ducpl2006/riscv_soc_de10_lite/tmp/pdfs/images/paper_obj_57.jpg

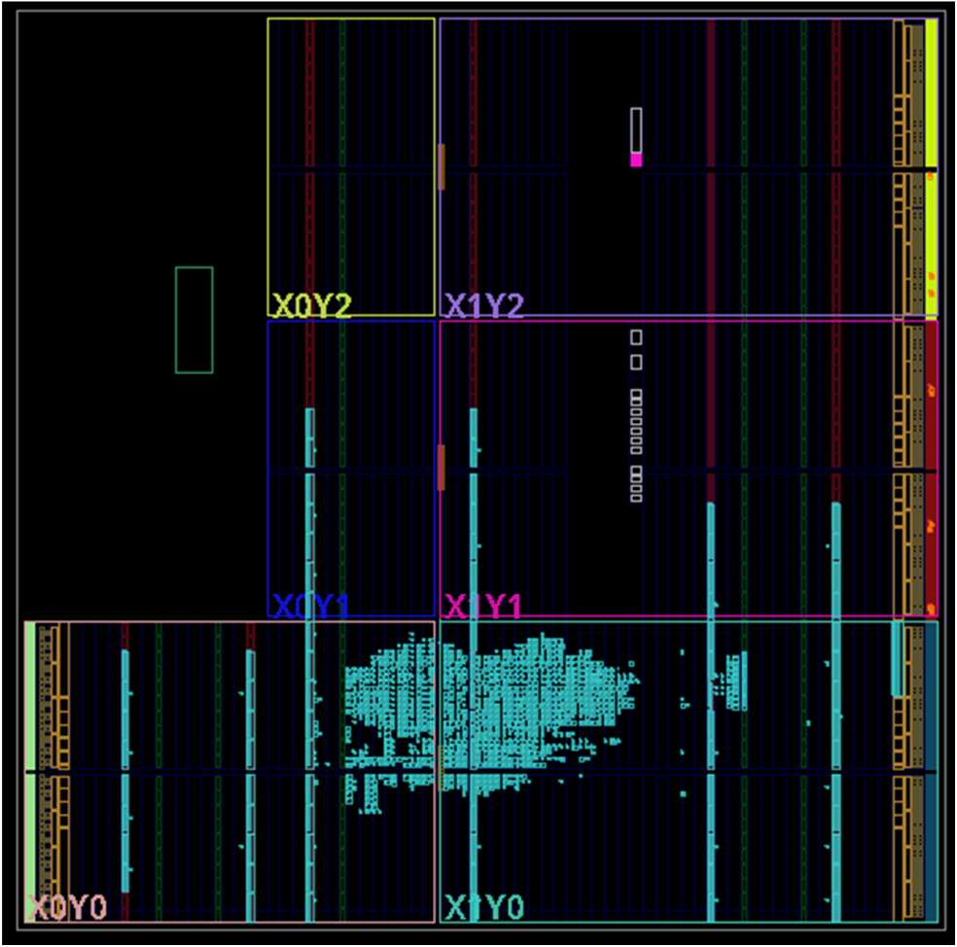
tmp/pdfs/images/paper_obj_57.jpg
