ducpl2006/riscv_soc_de10_lite/tmp/pdfs/images/paper_obj_48.jpg

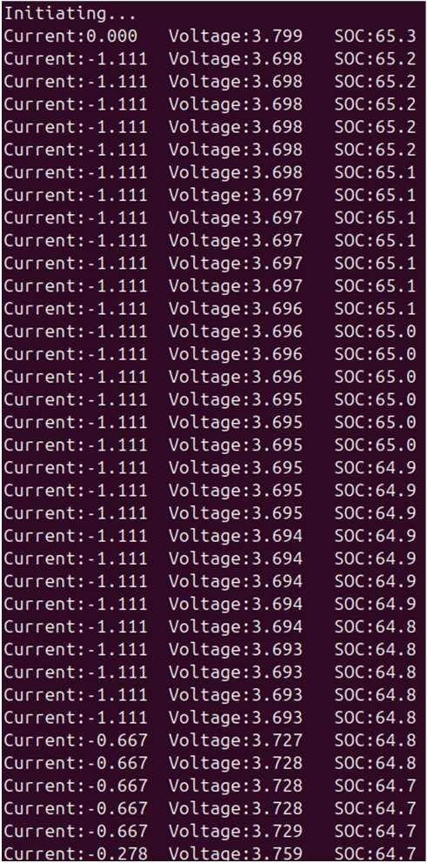
tmp/pdfs/images/paper_obj_48.jpg
