ducpl2006/riscv_soc_de10_lite/tmp/review_copy2_20260930/extract_list.txt

riscv_soc_de10_lite - Copy\.gitignore
riscv_soc_de10_lite - Copy\AGENTS.md
riscv_soc_de10_lite - Copy\docs\bao_cao_chat_luong_20260928_vi.md
riscv_soc_de10_lite - Copy\docs\bao_cao_freeze_isa_soc_vi.md
riscv_soc_de10_lite - Copy\docs\bao_cao_kien_truc_p0_p1_vi.md
riscv_soc_de10_lite - Copy\docs\bao_cao_xac_minh_vi.md
riscv_soc_de10_lite - Copy\docs\core_frozen_manifest.json
riscv_soc_de10_lite - Copy\docs\core_readability_baseline_20260929.zip
riscv_soc_de10_lite - Copy\docs\dac_ta_core_bus_ngoai_vi.md
riscv_soc_de10_lite - Copy\docs\doc_hieu_core_vi.md
riscv_soc_de10_lite - Copy\docs\firmware_ina228_vi.md
riscv_soc_de10_lite - Copy\docs\freeze_phase_files.json
riscv_soc_de10_lite - Copy\docs\giao_tiep_rtl_vi.md
riscv_soc_de10_lite - Copy\docs\hoc_hoi_soc_cnn_driver_vi.md
riscv_soc_de10_lite - Copy\docs\isa_scope_vi.md
riscv_soc_de10_lite - Copy\docs\isa_verification_vi.md
riscv_soc_de10_lite - Copy\docs\kiem_chung_board_vi.md
riscv_soc_de10_lite - Copy\docs\kien_truc_rv32i_vi.md
riscv_soc_de10_lite - Copy\docs\module_va_testbench_vi.md
riscv_soc_de10_lite - Copy\docs\soc_qnn_de10_lite_vi.md
riscv_soc_de10_lite - Copy\docs\timing_review_freeze_vi.md
riscv_soc_de10_lite - Copy\firmware\build\boot.hex
riscv_soc_de10_lite - Copy\firmware\build\boot.mif
riscv_soc_de10_lite - Copy\firmware\ina228.c
riscv_soc_de10_lite - Copy\firmware\include\board_config.h
riscv_soc_de10_lite - Copy\firmware\include\ina228.h
riscv_soc_de10_lite - Copy\firmware\include\model_config.h
riscv_soc_de10_lite - Copy\firmware\include\sample_pipeline.h
riscv_soc_de10_lite - Copy\firmware\include\soc_map.h
riscv_soc_de10_lite - Copy\firmware\include\soc_platform.h
riscv_soc_de10_lite - Copy\firmware\linker.ld
riscv_soc_de10_lite - Copy\firmware\main.c
riscv_soc_de10_lite - Copy\firmware\model\l1_biases.hex
riscv_soc_de10_lite - Copy\firmware\model\l1_weights.hex
riscv_soc_de10_lite - Copy\firmware\model\l1_weights.mif
riscv_soc_de10_lite - Copy\firmware\model\l2_biases.hex
riscv_soc_de10_lite - Copy\firmware\model\l2_weights.hex
riscv_soc_de10_lite - Copy\firmware\model\l2_weights.mif
riscv_soc_de10_lite - Copy\firmware\model\model_manifest.json
riscv_soc_de10_lite - Copy\firmware\model\out_bias.hex
riscv_soc_de10_lite - Copy\firmware\model\out_weights.hex
riscv_soc_de10_lite - Copy\firmware\model\verification_expected.hex
riscv_soc_de10_lite - Copy\firmware\model\verification_features.hex
riscv_soc_de10_lite - Copy\firmware\model\verification_meta.json
riscv_soc_de10_lite - Copy\firmware\runtime.c
riscv_soc_de10_lite - Copy\firmware\sample_pipeline.c
riscv_soc_de10_lite - Copy\firmware\soc_platform.c
riscv_soc_de10_lite - Copy\firmware\start.S
riscv_soc_de10_lite - Copy\ml\data\raw\SP2_0C_BJDST.zip
riscv_soc_de10_lite - Copy\ml\data\raw\SP2_0C_DST.zip
riscv_soc_de10_lite - Copy\ml\data\raw\SP2_0C_FUDS.zip
riscv_soc_de10_lite - Copy\ml\data\raw\SP2_0C_US06.zip
riscv_soc_de10_lite - Copy\ml\data\raw\SP2_25C_BJDST.zip
riscv_soc_de10_lite - Copy\ml\data\raw\SP2_25C_DST.zip
riscv_soc_de10_lite - Copy\ml\data\raw\SP2_25C_FUDS.zip
riscv_soc_de10_lite - Copy\ml\data\raw\SP2_25C_US06.zip
riscv_soc_de10_lite - Copy\ml\data\raw\SP2_45C_BJDST.zip
riscv_soc_de10_lite - Copy\ml\data\raw\SP2_45C_DST.zip
riscv_soc_de10_lite - Copy\ml\data\raw\SP2_45C_FUDS.zip
riscv_soc_de10_lite - Copy\ml\data\raw\SP2_45C_US06.zip
riscv_soc_de10_lite - Copy\ml\data\SHA256SUMS.txt
riscv_soc_de10_lite - Copy\ml\inspect_calce.py
riscv_soc_de10_lite - Copy\ml\requirements.txt
riscv_soc_de10_lite - Copy\ml\train_quantize_export.py
riscv_soc_de10_lite - Copy\quartus\riscv_soc.qpf
riscv_soc_de10_lite - Copy\quartus\riscv_soc.qsf
riscv_soc_de10_lite - Copy\quartus\riscv_soc.qws
riscv_soc_de10_lite - Copy\quartus\riscv_soc.sdc
riscv_soc_de10_lite - Copy\quartus\riscv_soc_nativelink_simulation.rpt
riscv_soc_de10_lite - Copy\README.md
riscv_soc_de10_lite - Copy\rtl\accelerator\qnn_model_config.vh
riscv_soc_de10_lite - Copy\rtl\accelerator\qnn_soc_accelerator.v
riscv_soc_de10_lite - Copy\rtl\board\de10_lite_top.v
riscv_soc_de10_lite - Copy\rtl\board\reset_controller.v
riscv_soc_de10_lite - Copy\rtl\bus\soc_bus.v
riscv_soc_de10_lite - Copy\rtl\bus\soc_map.vh
riscv_soc_de10_lite - Copy\rtl\core\common\rv32_lsu.v
riscv_soc_de10_lite - Copy\rtl\core\control\rv32_hazard_unit.v
riscv_soc_de10_lite - Copy\rtl\core\control\rv32_pipeline_control.v
riscv_soc_de10_lite - Copy\rtl\core\ex\rv32_alu.v
riscv_soc_de10_lite - Copy\rtl\core\ex\rv32_branch_unit.v
riscv_soc_de10_lite - Copy\rtl\core\ex\rv32_ex_stage.v
riscv_soc_de10_lite - Copy\rtl\core\id\rv32_decoder.v
riscv_soc_de10_lite - Copy\rtl\core\id\rv32_id_stage.v
riscv_soc_de10_lite - Copy\rtl\core\id\rv32_imm_gen.v
riscv_soc_de10_lite - Copy\rtl\core\id\rv32_regfile.v
riscv_soc_de10_lite - Copy\rtl\core\if\rv32_if_stage.v
riscv_soc_de10_lite - Copy\rtl\core\mem\rv32_mem_stage.v
riscv_soc_de10_lite - Copy\rtl\core\refactor_core.py
riscv_soc_de10_lite - Copy\rtl\core\rename_ports.py
riscv_soc_de10_lite - Copy\rtl\core\rename_ports_if.py
riscv_soc_de10_lite - Copy\rtl\core\rv32_core.v
riscv_soc_de10_lite - Copy\rtl\core\rv32_defs.vh
riscv_soc_de10_lite - Copy\rtl\core\rv32_pipeline_regs.v
riscv_soc_de10_lite - Copy\rtl\core\wb\rv32_wb_stage.v
riscv_soc_de10_lite - Copy\rtl\memory\intel_sync_ram_1p.v
riscv_soc_de10_lite - Copy\rtl\memory\intel_sync_rom_1p.v
riscv_soc_de10_lite - Copy\rtl\memory\intel_sync_rom_2p.v
riscv_soc_de10_lite - Copy\rtl\memory\soc_ram.v
riscv_soc_de10_lite - Copy\rtl\memory\soc_rom_dp.v
riscv_soc_de10_lite - Copy\rtl\peripherals\soc_gpio.v
riscv_soc_de10_lite - Copy\rtl\peripherals\soc_i2c_master.v
riscv_soc_de10_lite - Copy\rtl\peripherals\soc_timer.v
riscv_soc_de10_lite - Copy\rtl\peripherals\soc_uart_tx.v
riscv_soc_de10_lite - Copy\rtl\peripherals\uart\.gitignore
riscv_soc_de10_lite - Copy\rtl\peripherals\uart\docs\CHANGE_REPORT.md
riscv_soc_de10_lite - Copy\rtl\peripherals\uart\docs\LEARNING_GUIDE.md
riscv_soc_de10_lite - Copy\rtl\peripherals\uart\docs\SPECIFICATION.md
riscv_soc_de10_lite - Copy\rtl\peripherals\uart\quartus\pins.qsf
riscv_soc_de10_lite - Copy\rtl\peripherals\uart\quartus\README.md
riscv_soc_de10_lite - Copy\rtl\peripherals\uart\quartus\uart_loopback.qpf
riscv_soc_de10_lite - Copy\rtl\peripherals\uart\quartus\uart_loopback.qsf
riscv_soc_de10_lite - Copy\rtl\peripherals\uart\quartus\uart_loopback.sdc
riscv_soc_de10_lite - Copy\rtl\peripherals\uart\README.md
riscv_soc_de10_lite - Copy\rtl\peripherals\uart\rtl\reset_sync.v
riscv_soc_de10_lite - Copy\rtl\peripherals\uart\rtl\sync_fifo.v
riscv_soc_de10_lite - Copy\rtl\peripherals\uart\rtl\uart_baud_gen.v
riscv_soc_de10_lite - Copy\rtl\peripherals\uart\rtl\uart_loopback_top.v
riscv_soc_de10_lite - Copy\rtl\peripherals\uart\rtl\uart_rx.v
riscv_soc_de10_lite - Copy\rtl\peripherals\uart\rtl\uart_rx_sync.v
riscv_soc_de10_lite - Copy\rtl\peripherals\uart\rtl\uart_top.v
riscv_soc_de10_lite - Copy\rtl\peripherals\uart\rtl\uart_tx.v
riscv_soc_de10_lite - Copy\rtl\peripherals\uart\scripts\run_quartus_analysis.ps1
riscv_soc_de10_lite - Copy\rtl\peripherals\uart\scripts\run_tests.ps1
riscv_soc_de10_lite - Copy\rtl\peripherals\uart\soc_uart.v
riscv_soc_de10_lite - Copy\rtl\peripherals\uart\tb\tb_sync_fifo.v
riscv_soc_de10_lite - Copy\rtl\peripherals\uart\tb\tb_uart_baud_gen.v
riscv_soc_de10_lite - Copy\rtl\peripherals\uart\tb\tb_uart_loopback.v
riscv_soc_de10_lite - Copy\rtl\peripherals\uart\tb\tb_uart_rx.v
riscv_soc_de10_lite - Copy\rtl\peripherals\uart\tb\tb_uart_top.v
riscv_soc_de10_lite - Copy\rtl\peripherals\uart\tb\tb_uart_tx.v
riscv_soc_de10_lite - Copy\rtl\peripherals\uart\uart_rx.v
riscv_soc_de10_lite - Copy\rtl\peripherals\uart\uart_rx_fifo.v
riscv_soc_de10_lite - Copy\rtl\soc\rv32_soc.v
riscv_soc_de10_lite - Copy\scripts\build_firmware.ps1
riscv_soc_de10_lite - Copy\scripts\build_firmware.py
riscv_soc_de10_lite - Copy\scripts\check_core_freeze.py
riscv_soc_de10_lite - Copy\scripts\check_core_readability.py
riscv_soc_de10_lite - Copy\scripts\generate_firmware_vectors.py
riscv_soc_de10_lite - Copy\scripts\report_bus_timing.tcl
riscv_soc_de10_lite - Copy\scripts\report_freeze_phase.py
riscv_soc_de10_lite - Copy\scripts\report_timing.tcl
riscv_soc_de10_lite - Copy\scripts\run_firmware_tests.py
riscv_soc_de10_lite - Copy\scripts\run_isa.py
riscv_soc_de10_lite - Copy\scripts\run_tests.ps1
riscv_soc_de10_lite - Copy\scripts\run_tests.py
riscv_soc_de10_lite - Copy\scripts\setup_ml.ps1
riscv_soc_de10_lite - Copy\scripts\soc_rtl_sources.py
riscv_soc_de10_lite - Copy\scripts\train_model.ps1
riscv_soc_de10_lite - Copy\tb\accelerator\tb_rv32_qnn_model.v
riscv_soc_de10_lite - Copy\tb\accelerator\tb_rv32_qnn_soc_accelerator.v
riscv_soc_de10_lite - Copy\tb\bus\tb_rv32_soc_bus.v
riscv_soc_de10_lite - Copy\tb\core\common\tb_rv32_lsu.v
riscv_soc_de10_lite - Copy\tb\core\control\tb_rv32_hazard_unit.v
riscv_soc_de10_lite - Copy\tb\core\ex\tb_rv32_alu.v
riscv_soc_de10_lite - Copy\tb\core\ex\tb_rv32_branch_unit.v
riscv_soc_de10_lite - Copy\tb\core\id\tb_rv32_decoder.v
riscv_soc_de10_lite - Copy\tb\core\id\tb_rv32_imm_gen.v
riscv_soc_de10_lite - Copy\tb\core\id\tb_rv32_regfile.v
riscv_soc_de10_lite - Copy\tb\core\if\tb_rv32_if_stage.v
riscv_soc_de10_lite - Copy\tb\core\isa\env\link.ld
riscv_soc_de10_lite - Copy\tb\core\isa\env\riscv_test.h
riscv_soc_de10_lite - Copy\tb\core\isa\isa_core_harness.sv
riscv_soc_de10_lite - Copy\tb\core\tb_rv32_core.v
riscv_soc_de10_lite - Copy\tb\core\tb_rv32_core_fetch.v
riscv_soc_de10_lite - Copy\tb\core\tb_rv32_core_ordering.v
riscv_soc_de10_lite - Copy\tb\core\tb_rv32_core_traps.v
riscv_soc_de10_lite - Copy\tb\firmware\test_pipeline_ina228.c
riscv_soc_de10_lite - Copy\tb\memory\tb_rv32_soc_ram.v
riscv_soc_de10_lite - Copy\tb\memory\tb_rv32_soc_rom.v
riscv_soc_de10_lite - Copy\tb\peripherals\tb_rv32_gpio.v
riscv_soc_de10_lite - Copy\tb\peripherals\tb_rv32_i2c_master.v
riscv_soc_de10_lite - Copy\tb\peripherals\tb_rv32_i2c_recovery.v
riscv_soc_de10_lite - Copy\tb\peripherals\tb_rv32_i2c_transactions.v
riscv_soc_de10_lite - Copy\tb\peripherals\tb_rv32_timer.v
riscv_soc_de10_lite - Copy\tb\peripherals\tb_rv32_uart_fifo.v
riscv_soc_de10_lite - Copy\tb\peripherals\tb_rv32_uart_rx.v
riscv_soc_de10_lite - Copy\tb\peripherals\tb_rv32_uart_rx_fifo.v
riscv_soc_de10_lite - Copy\tb\peripherals\tb_rv32_uart_tx.v
riscv_soc_de10_lite - Copy\tb\soc\firmware_assets\build_manifest.json
riscv_soc_de10_lite - Copy\tb\soc\firmware_assets\bus_raw.hex
riscv_soc_de10_lite - Copy\tb\soc\firmware_assets\current_raw.hex
riscv_soc_de10_lite - Copy\tb\soc\firmware_assets\fake.hex
riscv_soc_de10_lite - Copy\tb\soc\firmware_assets\fake_features.hex
riscv_soc_de10_lite - Copy\tb\soc\firmware_assets\fake_reference.json
riscv_soc_de10_lite - Copy\tb\soc\firmware_assets\fake_results.hex
riscv_soc_de10_lite - Copy\tb\soc\firmware_assets\fake_uart.hex
riscv_soc_de10_lite - Copy\tb\soc\firmware_assets\fake_uart_length.hex
riscv_soc_de10_lite - Copy\tb\soc\firmware_assets\ina228.hex
riscv_soc_de10_lite - Copy\tb\soc\firmware_assets\ina228_features.hex
riscv_soc_de10_lite - Copy\tb\soc\firmware_assets\ina228_reference.json
riscv_soc_de10_lite - Copy\tb\soc\firmware_assets\ina228_results.hex
riscv_soc_de10_lite - Copy\tb\soc\firmware_assets\ina228_uart.hex
riscv_soc_de10_lite - Copy\tb\soc\firmware_assets\ina228_uart_length.hex
riscv_soc_de10_lite - Copy\tb\soc\firmware_assets\shunt_raw.hex
riscv_soc_de10_lite - Copy\tb\soc\tb_rv32_core_bus_wait.v
riscv_soc_de10_lite - Copy\tb\soc\tb_rv32_firmware_e2e.sv
riscv_soc_de10_lite - Copy\tb\soc\tb_rv32_reset_controller.v
riscv_soc_de10_lite - Copy\tb\soc\tb_rv32_soc.v
riscv_soc_de10_lite - Copy\tb\soc\tb_rv32_soc_mmio.v
riscv_soc_de10_lite - Copy\tb\soc\tb_rv32_soc_uart_rx.v
riscv_soc_de10_lite - Copy\third_party\README.md
riscv_soc_de10_lite - Copy\third_party\riscv-tests\.github\workflows\debug.yml
riscv_soc_de10_lite - Copy\third_party\riscv-tests\.github\workflows\spike-openocd-tests.yml
riscv_soc_de10_lite - Copy\third_party\riscv-tests\.github\workflows\spike-tests.yml
riscv_soc_de10_lite - Copy\third_party\riscv-tests\.gitignore
riscv_soc_de10_lite - Copy\third_party\riscv-tests\.gitmodules
riscv_soc_de10_lite - Copy\third_party\riscv-tests\benchmarks\common\crt.S
riscv_soc_de10_lite - Copy\third_party\riscv-tests\benchmarks\common\syscalls.c
riscv_soc_de10_lite - Copy\third_party\riscv-tests\benchmarks\common\test.ld
riscv_soc_de10_lite - Copy\third_party\riscv-tests\benchmarks\common\util.h
riscv_soc_de10_lite - Copy\third_party\riscv-tests\benchmarks\dhrystone\dhrystone.c
riscv_soc_de10_lite - Copy\third_party\riscv-tests\benchmarks\dhrystone\dhrystone.h
riscv_soc_de10_lite - Copy\third_party\riscv-tests\benchmarks\dhrystone\dhrystone_main.c
riscv_soc_de10_lite - Copy\third_party\riscv-tests\benchmarks\Makefile
riscv_soc_de10_lite - Copy\third_party\riscv-tests\benchmarks\median\dataset1.h
riscv_soc_de10_lite - Copy\third_party\riscv-tests\benchmarks\median\median.c
riscv_soc_de10_lite - Copy\third_party\riscv-tests\benchmarks\median\median.h
riscv_soc_de10_lite - Copy\third_party\riscv-tests\benchmarks\median\median_gendata.pl
riscv_soc_de10_lite - Copy\third_party\riscv-tests\benchmarks\median\median_main.c
riscv_soc_de10_lite - Copy\third_party\riscv-tests\benchmarks\memcpy\dataset1.h
riscv_soc_de10_lite - Copy\third_party\riscv-tests\benchmarks\memcpy\memcpy_gendata.pl
riscv_soc_de10_lite - Copy\third_party\riscv-tests\benchmarks\memcpy\memcpy_main.c
riscv_soc_de10_lite - Copy\third_party\riscv-tests\benchmarks\mm\common.h
riscv_soc_de10_lite - Copy\third_party\riscv-tests\benchmarks\mm\gen.scala
riscv_soc_de10_lite - Copy\third_party\riscv-tests\benchmarks\mm\mm.c
riscv_soc_de10_lite - Copy\third_party\riscv-tests\benchmarks\mm\mm_main.c
riscv_soc_de10_lite - Copy\third_party\riscv-tests\benchmarks\mm\rb.h
riscv_soc_de10_lite - Copy\third_party\riscv-tests\benchmarks\mt-matmul\dataset.h
riscv_soc_de10_lite - Copy\third_party\riscv-tests\benchmarks\mt-matmul\matmul.c
riscv_soc_de10_lite - Copy\third_party\riscv-tests\benchmarks\mt-matmul\matmul_gendata.pl
riscv_soc_de10_lite - Copy\third_party\riscv-tests\benchmarks\mt-matmul\mt-matmul.c
riscv_soc_de10_lite - Copy\third_party\riscv-tests\benchmarks\mt-memcpy\dataset1.h
riscv_soc_de10_lite - Copy\third_party\riscv-tests\benchmarks\mt-memcpy\memcpy_gendata.pl
riscv_soc_de10_lite - Copy\third_party\riscv-tests\benchmarks\mt-memcpy\mt-memcpy.c
riscv_soc_de10_lite - Copy\third_party\riscv-tests\benchmarks\mt-vvadd\dataset.h
riscv_soc_de10_lite - Copy\third_party\riscv-tests\benchmarks\mt-vvadd\mt-vvadd.c
riscv_soc_de10_lite - Copy\third_party\riscv-tests\benchmarks\mt-vvadd\vvadd.c
riscv_soc_de10_lite - Copy\third_party\riscv-tests\benchmarks\mt-vvadd\vvadd_gendata.pl
riscv_soc_de10_lite - Copy\third_party\riscv-tests\benchmarks\multiply\dataset1.h
riscv_soc_de10_lite - Copy\third_party\riscv-tests\benchmarks\multiply\multiply.c
riscv_soc_de10_lite - Copy\third_party\riscv-tests\benchmarks\multiply\multiply.h
riscv_soc_de10_lite - Copy\third_party\riscv-tests\benchmarks\multiply\multiply_gendata.pl
riscv_soc_de10_lite - Copy\third_party\riscv-tests\benchmarks\multiply\multiply_main.c
riscv_soc_de10_lite - Copy\third_party\riscv-tests\benchmarks\pmp\pmp.c
riscv_soc_de10_lite - Copy\third_party\riscv-tests\benchmarks\qsort\dataset1.h
riscv_soc_de10_lite - Copy\third_party\riscv-tests\benchmarks\qsort\qsort_gendata.pl
riscv_soc_de10_lite - Copy\third_party\riscv-tests\benchmarks\qsort\qsort_main.c
riscv_soc_de10_lite - Copy\third_party\riscv-tests\benchmarks\readme.txt
riscv_soc_de10_lite - Copy\third_party\riscv-tests\benchmarks\rsort\dataset1.h
riscv_soc_de10_lite - Copy\third_party\riscv-tests\benchmarks\rsort\rsort.c
riscv_soc_de10_lite - Copy\third_party\riscv-tests\benchmarks\spmv\dataset1.h
riscv_soc_de10_lite - Copy\third_party\riscv-tests\benchmarks\spmv\spmv_gendata.scala
riscv_soc_de10_lite - Copy\third_party\riscv-tests\benchmarks\spmv\spmv_main.c
riscv_soc_de10_lite - Copy\third_party\riscv-tests\benchmarks\towers\towers_main.c
riscv_soc_de10_lite - Copy\third_party\riscv-tests\benchmarks\vec-daxpy\dataset1.h
riscv_soc_de10_lite - Copy\third_party\riscv-tests\benchmarks\vec-daxpy\daxpy_gendata.pl
riscv_soc_de10_lite - Copy\third_party\riscv-tests\benchmarks\vec-daxpy\vec-daxpy.S
riscv_soc_de10_lite - Copy\third_party\riscv-tests\benchmarks\vec-daxpy\vec-daxpy_main.c
riscv_soc_de10_lite - Copy\third_party\riscv-tests\benchmarks\vec-memcpy\dataset1.h
riscv_soc_de10_lite - Copy\third_party\riscv-tests\benchmarks\vec-memcpy\memcpy_gendata.pl
riscv_soc_de10_lite - Copy\third_party\riscv-tests\benchmarks\vec-memcpy\vec-memcpy.S
riscv_soc_de10_lite - Copy\third_party\riscv-tests\benchmarks\vec-memcpy\vec-memcpy_main.c
riscv_soc_de10_lite - Copy\third_party\riscv-tests\benchmarks\vec-sgemm\dataset1.h
riscv_soc_de10_lite - Copy\third_party\riscv-tests\benchmarks\vec-sgemm\sgemm_gendata.pl
riscv_soc_de10_lite - Copy\third_party\riscv-tests\benchmarks\vec-sgemm\vec-sgemm.S
riscv_soc_de10_lite - Copy\third_party\riscv-tests\benchmarks\vec-sgemm\vec-sgemm_main.c
riscv_soc_de10_lite - Copy\third_party\riscv-tests\benchmarks\vec-strcmp\vec-strcmp.S
riscv_soc_de10_lite - Copy\third_party\riscv-tests\benchmarks\vec-strcmp\vec-strcmp_main.c
riscv_soc_de10_lite - Copy\third_party\riscv-tests\benchmarks\vvadd\dataset1-large.h
riscv_soc_de10_lite - Copy\third_party\riscv-tests\benchmarks\vvadd\dataset1.h
riscv_soc_de10_lite - Copy\third_party\riscv-tests\benchmarks\vvadd\vvadd_gendata.pl
riscv_soc_de10_lite - Copy\third_party\riscv-tests\benchmarks\vvadd\vvadd_main.c
riscv_soc_de10_lite - Copy\third_party\riscv-tests\configure
riscv_soc_de10_lite - Copy\third_party\riscv-tests\configure.ac
riscv_soc_de10_lite - Copy\third_party\riscv-tests\debug\bin\README.md
riscv_soc_de10_lite - Copy\third_party\riscv-tests\debug\bin\RTOSDemo32.axf
riscv_soc_de10_lite - Copy\third_party\riscv-tests\debug\bin\RTOSDemo64.axf
riscv_soc_de10_lite - Copy\third_party\riscv-tests\debug\excluded.yaml.example
riscv_soc_de10_lite - Copy\third_party\riscv-tests\debug\gdbserver.py
riscv_soc_de10_lite - Copy\third_party\riscv-tests\debug\hifive1_excludes.yaml
riscv_soc_de10_lite - Copy\third_party\riscv-tests\debug\Makefile
riscv_soc_de10_lite - Copy\third_party\riscv-tests\debug\openocd.py
riscv_soc_de10_lite - Copy\third_party\riscv-tests\debug\programs\checksum.c
riscv_soc_de10_lite - Copy\third_party\riscv-tests\debug\programs\counting_loop.c
riscv_soc_de10_lite - Copy\third_party\riscv-tests\debug\programs\debug.c
riscv_soc_de10_lite - Copy\third_party\riscv-tests\debug\programs\ebreak.c
riscv_soc_de10_lite - Copy\third_party\riscv-tests\debug\programs\entry.S
riscv_soc_de10_lite - Copy\third_party\riscv-tests\debug\programs\infinite_loop.S
riscv_soc_de10_lite - Copy\third_party\riscv-tests\debug\programs\init.c
riscv_soc_de10_lite - Copy\third_party\riscv-tests\debug\programs\init.h
riscv_soc_de10_lite - Copy\third_party\riscv-tests\debug\programs\interrupt.c
riscv_soc_de10_lite - Copy\third_party\riscv-tests\debug\programs\mprv.S
riscv_soc_de10_lite - Copy\third_party\riscv-tests\debug\programs\multicore.c
riscv_soc_de10_lite - Copy\third_party\riscv-tests\debug\programs\priv.S
riscv_soc_de10_lite - Copy\third_party\riscv-tests\debug\programs\regs.S
riscv_soc_de10_lite - Copy\third_party\riscv-tests\debug\programs\run_halt_timing.S
riscv_soc_de10_lite - Copy\third_party\riscv-tests\debug\programs\semihosting.c
riscv_soc_de10_lite - Copy\third_party\riscv-tests\debug\programs\semihosting.h
riscv_soc_de10_lite - Copy\third_party\riscv-tests\debug\programs\step.S
riscv_soc_de10_lite - Copy\third_party\riscv-tests\debug\programs\tiny-malloc.c
riscv_soc_de10_lite - Copy\third_party\riscv-tests\debug\programs\translate.c
riscv_soc_de10_lite - Copy\third_party\riscv-tests\debug\programs\trigger.S
riscv_soc_de10_lite - Copy\third_party\riscv-tests\debug\programs\vectors.S
riscv_soc_de10_lite - Copy\third_party\riscv-tests\debug\pylint.rc
riscv_soc_de10_lite - Copy\third_party\riscv-tests\debug\rbb_daisychain.py
riscv_soc_de10_lite - Copy\third_party\riscv-tests\debug\README.md
riscv_soc_de10_lite - Copy\third_party\riscv-tests\debug\requirements.txt
riscv_soc_de10_lite - Copy\third_party\riscv-tests\debug\targets\RISC-V\spike-1.cfg
riscv_soc_de10_lite - Copy\third_party\riscv-tests\debug\targets\RISC-V\spike-2-hwthread.cfg
riscv_soc_de10_lite - Copy\third_party\riscv-tests\debug\targets\RISC-V\spike-2.cfg
riscv_soc_de10_lite - Copy\third_party\riscv-tests\debug\targets\RISC-V\spike-multi.cfg
riscv_soc_de10_lite - Copy\third_party\riscv-tests\debug\targets\RISC-V\spike-multi.py
riscv_soc_de10_lite - Copy\third_party\riscv-tests\debug\targets\RISC-V\spike32-2-hwthread.py
riscv_soc_de10_lite - Copy\third_party\riscv-tests\debug\targets\RISC-V\spike32-2.py
riscv_soc_de10_lite - Copy\third_party\riscv-tests\debug\targets\RISC-V\spike32.lds
riscv_soc_de10_lite - Copy\third_party\riscv-tests\debug\targets\RISC-V\spike32.py
riscv_soc_de10_lite - Copy\third_party\riscv-tests\debug\targets\RISC-V\spike64-2-hwthread.py
riscv_soc_de10_lite - Copy\third_party\riscv-tests\debug\targets\RISC-V\spike64-2-rtos.py
riscv_soc_de10_lite - Copy\third_party\riscv-tests\debug\targets\RISC-V\spike64-2.py
riscv_soc_de10_lite - Copy\third_party\riscv-tests\debug\targets\RISC-V\spike64.lds
riscv_soc_de10_lite - Copy\third_party\riscv-tests\debug\targets\RISC-V\spike64.py
riscv_soc_de10_lite - Copy\third_party\riscv-tests\debug\targets\SiFive\Freedom\E300.py
riscv_soc_de10_lite - Copy\third_party\riscv-tests\debug\targets\SiFive\Freedom\Freedom.cfg
riscv_soc_de10_lite - Copy\third_party\riscv-tests\debug\targets\SiFive\Freedom\Freedom.lds
riscv_soc_de10_lite - Copy\third_party\riscv-tests\debug\targets\SiFive\Freedom\U500.py
riscv_soc_de10_lite - Copy\third_party\riscv-tests\debug\targets\SiFive\Freedom\U500Sim.py
riscv_soc_de10_lite - Copy\third_party\riscv-tests\debug\targets\SiFive\HiFive1-flash.lds
riscv_soc_de10_lite - Copy\third_party\riscv-tests\debug\targets\SiFive\HiFive1-flash.py
riscv_soc_de10_lite - Copy\third_party\riscv-tests\debug\targets\SiFive\HiFive1.cfg
riscv_soc_de10_lite - Copy\third_party\riscv-tests\debug\targets\SiFive\HiFive1.lds
riscv_soc_de10_lite - Copy\third_party\riscv-tests\debug\targets\SiFive\HiFive1.py
riscv_soc_de10_lite - Copy\third_party\riscv-tests\debug\targets\SiFive\HiFiveUnleashed-flash.lds
riscv_soc_de10_lite - Copy\third_party\riscv-tests\debug\targets\SiFive\HiFiveUnleashed-flash.py
riscv_soc_de10_lite - Copy\third_party\riscv-tests\debug\targets\SiFive\HiFiveUnleashed.cfg
riscv_soc_de10_lite - Copy\third_party\riscv-tests\debug\targets\SiFive\HiFiveUnleashed.lds
riscv_soc_de10_lite - Copy\third_party\riscv-tests\debug\targets\SiFive\HiFiveUnleashed.py
riscv_soc_de10_lite - Copy\third_party\riscv-tests\debug\targets\SiFive\HiFiveUnleashed_setup.bin
riscv_soc_de10_lite - Copy\third_party\riscv-tests\debug\targets.py
riscv_soc_de10_lite - Copy\third_party\riscv-tests\debug\testlib.py
riscv_soc_de10_lite - Copy\third_party\riscv-tests\isa\.gitignore
riscv_soc_de10_lite - Copy\third_party\riscv-tests\isa\hypervisor\2-stage_translation.S
riscv_soc_de10_lite - Copy\third_party\riscv-tests\isa\hypervisor\2-stage_translation_implicit_load_error.S
riscv_soc_de10_lite - Copy\third_party\riscv-tests\isa\hypervisor\2-stage_translation_implicit_load_error_hs.S
riscv_soc_de10_lite - Copy\third_party\riscv-tests\isa\hypervisor\Makefrag
riscv_soc_de10_lite - Copy\third_party\riscv-tests\isa\hypervisor-svadu\2-stage_translation_implicit_store_error.S
riscv_soc_de10_lite - Copy\third_party\riscv-tests\isa\hypervisor-svadu\2-stage_translation_implicit_store_error_hs.S
riscv_soc_de10_lite - Copy\third_party\riscv-tests\isa\hypervisor-svadu\Makefrag
riscv_soc_de10_lite - Copy\third_party\riscv-tests\isa\hypervisor-zicclsm\2-stage_misaligned_load_crossing_page_boundary_gstage_fault.S
riscv_soc_de10_lite - Copy\third_party\riscv-tests\isa\hypervisor-zicclsm\2-stage_misaligned_load_crossing_page_boundary_vsstage_fault.S
riscv_soc_de10_lite - Copy\third_party\riscv-tests\isa\hypervisor-zicclsm\Makefrag
riscv_soc_de10_lite - Copy\third_party\riscv-tests\isa\macros\scalar\test_macros.h
riscv_soc_de10_lite - Copy\third_party\riscv-tests\isa\Makefile
riscv_soc_de10_lite - Copy\third_party\riscv-tests\isa\rv32mi\breakpoint.S
riscv_soc_de10_lite - Copy\third_party\riscv-tests\isa\rv32mi\csr.S
riscv_soc_de10_lite - Copy\third_party\riscv-tests\isa\rv32mi\illegal.S
riscv_soc_de10_lite - Copy\third_party\riscv-tests\isa\rv32mi\instret_overflow.S
riscv_soc_de10_lite - Copy\third_party\riscv-tests\isa\rv32mi\lh-misaligned.S
riscv_soc_de10_lite - Copy\third_party\riscv-tests\isa\rv32mi\lw-misaligned.S
riscv_soc_de10_lite - Copy\third_party\riscv-tests\isa\rv32mi\Makefrag
riscv_soc_de10_lite - Copy\third_party\riscv-tests\isa\rv32mi\ma_addr.S
riscv_soc_de10_lite - Copy\third_party\riscv-tests\isa\rv32mi\ma_fetch.S
riscv_soc_de10_lite - Copy\third_party\riscv-tests\isa\rv32mi\mcsr.S
riscv_soc_de10_lite - Copy\third_party\riscv-tests\isa\rv32mi\pmpaddr.S
riscv_soc_de10_lite - Copy\third_party\riscv-tests\isa\rv32mi\sbreak.S
riscv_soc_de10_lite - Copy\third_party\riscv-tests\isa\rv32mi\scall.S
riscv_soc_de10_lite - Copy\third_party\riscv-tests\isa\rv32mi\sh-misaligned.S
riscv_soc_de10_lite - Copy\third_party\riscv-tests\isa\rv32mi\shamt.S
riscv_soc_de10_lite - Copy\third_party\riscv-tests\isa\rv32mi\sw-misaligned.S
riscv_soc_de10_lite - Copy\third_party\riscv-tests\isa\rv32mi\zicntr.S
riscv_soc_de10_lite - Copy\third_party\riscv-tests\isa\rv32si\csr.S
riscv_soc_de10_lite - Copy\third_party\riscv-tests\isa\rv32si\dirty.S
riscv_soc_de10_lite - Copy\third_party\riscv-tests\isa\rv32si\Makefrag
riscv_soc_de10_lite - Copy\third_party\riscv-tests\isa\rv32si\ma_fetch.S
riscv_soc_de10_lite - Copy\third_party\riscv-tests\isa\rv32si\sbreak.S
riscv_soc_de10_lite - Copy\third_party\riscv-tests\isa\rv32si\scall.S
riscv_soc_de10_lite - Copy\third_party\riscv-tests\isa\rv32si\wfi.S
riscv_soc_de10_lite - Copy\third_party\riscv-tests\isa\rv32ua\amoadd_w.S
riscv_soc_de10_lite - Copy\third_party\riscv-tests\isa\rv32ua\amoand_w.S
riscv_soc_de10_lite - Copy\third_party\riscv-tests\isa\rv32ua\amocas_d.S
riscv_soc_de10_lite - Copy\third_party\riscv-tests\isa\rv32ua\amocas_w.S
riscv_soc_de10_lite - Copy\third_party\riscv-tests\isa\rv32ua\amomaxu_w.S
riscv_soc_de10_lite - Copy\third_party\riscv-tests\isa\rv32ua\amomax_w.S
riscv_soc_de10_lite - Copy\third_party\riscv-tests\isa\rv32ua\amominu_w.S
riscv_soc_de10_lite - Copy\third_party\riscv-tests\isa\rv32ua\amomin_w.S
riscv_soc_de10_lite - Copy\third_party\riscv-tests\isa\rv32ua\amoor_w.S
riscv_soc_de10_lite - Copy\third_party\riscv-tests\isa\rv32ua\amoswap_w.S
riscv_soc_de10_lite - Copy\third_party\riscv-tests\isa\rv32ua\amoxor_w.S
riscv_soc_de10_lite - Copy\third_party\riscv-tests\isa\rv32ua\lrsc.S
riscv_soc_de10_lite - Copy\third_party\riscv-tests\isa\rv32ua\Makefrag
riscv_soc_de10_lite - Copy\third_party\riscv-tests\isa\rv32uc\Makefrag
riscv_soc_de10_lite - Copy\third_party\riscv-tests\isa\rv32uc\rvc.S
riscv_soc_de10_lite - Copy\third_party\riscv-tests\isa\rv32ud\fadd.S
riscv_soc_de10_lite - Copy\third_party\riscv-tests\isa\rv32ud\fclass.S
riscv_soc_de10_lite - Copy\third_party\riscv-tests\isa\rv32ud\fcmp.S
riscv_soc_de10_lite - Copy\third_party\riscv-tests\isa\rv32ud\fcvt.S
riscv_soc_de10_lite - Copy\third_party\riscv-tests\isa\rv32ud\fcvt_w.S
riscv_soc_de10_lite - Copy\third_party\riscv-tests\isa\rv32ud\fdiv.S
riscv_soc_de10_lite - Copy\third_party\riscv-tests\isa\rv32ud\fmadd.S
riscv_soc_de10_lite - Copy\third_party\riscv-tests\isa\rv32ud\fmin.S
riscv_soc_de10_lite - Copy\third_party\riscv-tests\isa\rv32ud\ldst.S
riscv_soc_de10_lite - Copy\third_party\riscv-tests\isa\rv32ud\Makefrag
riscv_soc_de10_lite - Copy\third_party\riscv-tests\isa\rv32ud\move.S
riscv_soc_de10_lite - Copy\third_party\riscv-tests\isa\rv32ud\recoding.S
riscv_soc_de10_lite - Copy\third_party\riscv-tests\isa\rv32uf\fadd.S
riscv_soc_de10_lite - Copy\third_party\riscv-tests\isa\rv32uf\fclass.S
riscv_soc_de10_lite - Copy\third_party\riscv-tests\isa\rv32uf\fcmp.S
riscv_soc_de10_lite - Copy\third_party\riscv-tests\isa\rv32uf\fcvt.S
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
riscv_soc_de10_lite - Copy\third_party\riscv-tests\mt\ds_matmul.c
riscv_soc_de10_lite - Copy\third_party\riscv-tests\mt\du_matmul.c
riscv_soc_de10_lite - Copy\third_party\riscv-tests\mt\dv_matmul.c
riscv_soc_de10_lite - Copy\third_party\riscv-tests\mt\Makefile
riscv_soc_de10_lite - Copy\third_party\riscv-tests\mt\vvadd0.c
riscv_soc_de10_lite - Copy\third_party\riscv-tests\mt\vvadd1.c
riscv_soc_de10_lite - Copy\third_party\riscv-tests\mt\vvadd2.c
riscv_soc_de10_lite - Copy\third_party\riscv-tests\mt\vvadd3.c
riscv_soc_de10_lite - Copy\third_party\riscv-tests\mt\vvadd4.c
riscv_soc_de10_lite - Copy\third_party\riscv-tests\README.md
