ducpl2006/riscv_soc_de10_lite/tmp/review_copy2_20260930/riscv_soc_de10_lite - Copy/docs/doc_hieu_core_vi.md

# Đọc hiểu core RV32I

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

## 1. Bắt đầu từ đâu

Đọc [rv32_core.v](../rtl/core/rv32_core.v) theo ba phần: khai báo ranh giới
pipeline, nối các module con, rồi khối cập nhật thanh ghi tại cạnh lên.
Sau đó lần theo module thực hiện phép tính cần tìm:

| Tệp | Trách nhiệm |
|---|---|
| [rv32_defs.vh](../rtl/core/rv32_defs.vh) | Mã điều khiển ALU, immediate, forwarding, ghi về và nguyên nhân ngoại lệ |
| [rv32_if_stage.v](../rtl/core/if/rv32_if_stage.v) | Phát yêu cầu lấy lệnh, giữ metadata, FIFO hai phần tử, loại đáp ứng sai đường |
| [rv32_id_stage.v](../rtl/core/id/rv32_id_stage.v) | Ghép giải mã, immediate, đọc thanh ghi và ngoại lệ ID |
| [rv32_decoder.v](../rtl/core/id/rv32_decoder.v), [rv32_imm_gen.v](../rtl/core/id/rv32_imm_gen.v), [rv32_regfile.v](../rtl/core/id/rv32_regfile.v) | Chọn phép toán, dựng hằng tức thời, lưu thanh ghi và chuyển tiếp WB → ID |
| [rv32_ex_stage.v](../rtl/core/ex/rv32_ex_stage.v) | Chọn dữ liệu chuyển tiếp, toán hạng ALU, đích nhảy và lỗi căn chỉnh |
| [rv32_alu.v](../rtl/core/ex/rv32_alu.v), [rv32_branch_unit.v](../rtl/core/ex/rv32_branch_unit.v) | Tính kết quả số học/logic và điều kiện nhánh |
| [rv32_lsu.v](../rtl/core/common/rv32_lsu.v) | Kiểm tra căn chỉnh, chọn byte, tạo dữ liệu ghi và mở rộng dữ liệu đọc |
| [rv32_mem_stage.v](../rtl/core/mem/rv32_mem_stage.v) | Tạo giao dịch dữ liệu, báo chờ/lỗi, chọn dữ liệu ghi về |
| [rv32_wb_stage.v](../rtl/core/wb/rv32_wb_stage.v) | Cho phép ghi thanh ghi, xuất trace, chốt trap và trạng thái dừng |
| [rv32_hazard_unit.v](../rtl/core/control/rv32_hazard_unit.v) | Phát hiện phụ thuộc load-use, chọn nguồn chuyển tiếp cho từng toán hạng |
| [rv32_pipeline_control.v](../rtl/core/control/rv32_pipeline_control.v) | Phân xử sự kiện và quyết định ID có được lấy lệnh từ FIFO hay không |

Luồng chính là `IF/FIFO → ID → ID/EX → EX → EX/MEM → MEM → MEM/WB → WB`.
ID, EX, MEM xử lý tổ hợp; trạng thái thanh ghi chung nằm trong `rv32_core`.
IF tự giữ trạng thái lấy lệnh; register file và WB cũng có trạng thái riêng.
LSU được dùng ở EX để kiểm tra căn chỉnh, ở MEM để xử lý dữ liệu bus.

## 2. Đọc tên và dữ liệu đi kèm

- `_i`, `_o`: hướng cổng theo module khai báo, không phải vị trí trong toàn core.
- `_q`: trạng thái đã chốt. Riêng `ifid_*_q` và `halted_q` trong top là dây
  nối trạng thái do module con giữ.
- `idex_*`, `exmem_*`, `memwb_*`: dữ liệu của lệnh tại ranh giới tương ứng.
- `*_raw`: kết quả phát hiện trước phân xử toàn pipeline; `*_event`: sự kiện
  đưa vào điều khiển. Vẫn phải đọc điều kiện reset, halt và ưu tiên tại nơi dùng.
- `valid=0`: không có lệnh; những bit dữ liệu còn lại có thể giữ giá trị cũ.
  `valid=1, exc_valid=1`: có một lệnh/phần tử lỗi đang đi tới WB.

Trong bảng sau, tên trường lược bỏ tiền tố ranh giới và hậu tố `_q`.

| Ranh giới | Dữ liệu được giữ | Nơi giữ |
|---|---|---|
| IF/ID | `valid`, `pc`, `instr`, `exc_valid`, `exc_cause` | Phần tử đầu FIFO trong IF; `valid` suy ra từ số phần tử |
| ID/EX | Nhận dạng: `valid`, `pc`, `instr`, `pc4`; nguồn/đích: `rs1_addr`, `rs2_addr`, `rd_addr`, `rs1_data`, `rs2_data`; giải mã: `imm`, `funct3`, `alu_op`, `op_a_sel`, `op_b_imm`, `reg_write`, `wb_sel`, `branch`, `jal`, `jalr`, `load`, `store`; lỗi: `exc_valid`, `exc_cause` | Top core |
| EX/MEM | `valid`, `pc`, `instr`, `pc4`, `rd_addr`, `reg_write`, `wb_sel`, `alu_result`, `store_data`, `funct3`, `load`, `store`, `exc_valid`, `exc_cause` | Top core |
| MEM/WB | `valid`, `pc`, `instr`, `rd_addr`, `reg_write`, `wb_data`, `exc_valid`, `exc_cause` | Top core |

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

## 3. Giữ, chèn rỗng, xóa, đổi hướng và trap

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

Ưu tiên phải đọc tại cả bộ điều khiển lẫn khối tuần tự top. Bảng mô tả
cạnh xử lý khi không có reset/halt ưu tiên hơn; lệnh ở WB già hơn MEM,
MEM già hơn EX, EX già hơn ID.

| Các điều kiện cùng xuất hiện | Kết quả tại cạnh xử lý |
|---|---|
| Reset và mọi sự kiện khác | Reset trạng thái, xóa pipeline; chặn yêu cầu bộ nhớ |
| `wb_trap_event` và sự kiện trẻ hơn | WB chốt trap; top xóa ba `valid`; IF xóa FIFO và đánh dấu hủy yêu cầu cũ; MEM chặn yêu cầu dữ liệu |
| Đã `halted_q=1` | Không tiến pipeline, không ghi thanh ghi; yêu cầu instruction đã phát vẫn phải được nhận và đáp ứng vẫn được thu dọn |
| `mem_stall` và lỗi/redirect EX hoặc ngoại lệ ID | EX/ID chờ; không tiêu thụ IF/ID. WB cũ hoàn tất một lần, rồi `memwb_valid_q` bị xóa |
| `mem_fault_event` và lỗi/redirect EX hoặc ngoại lệ ID | Lỗi MEM đi vào MEM/WB; xóa lệnh tại EX/ID và FIFO. Lệnh WB cũ không lỗi vẫn hoàn tất |
| Đích nhảy EX lệch hàng | `ex_fault_event` có hiệu lực; điều kiện căn chỉnh chặn redirect. Lệnh lỗi đi vào EX/MEM, các lệnh trẻ hơn bị xóa |
| Redirect EX hợp lệ và ngoại lệ/load-use tại ID | Redirect thắng; lệnh EX tiếp tục, ID/EX và FIFO bị xóa |
| Ngoại lệ giải mã ID, không có cản trở già hơn | ID chuyển lệnh lỗi vào ID/EX; IF dừng phát mới và xóa FIFO. Lỗi fetch có sẵn được giữ nguyên cause |
| Load-use, không có cản trở già hơn | ID không tiêu thụ FIFO, ID/EX thành bubble; load vẫn sang EX/MEM |

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

## 4. Theo dấu ba lệnh

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

## 5. Chuyển tiếp và chờ MEM

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

Trong MEM chờ, WB cũ có thể rời pipeline trước lệnh đang đứng tại EX.
Vì vậy top chốt `ex_rs1_value`, `ex_rs2_value` trở lại hai thanh ghi dữ
liệu ID/EX ở mỗi cạnh chờ. Khi MEM/WB mất `valid`, EX vẫn có giá trị đúng.
Không hiểu “giữ ID/EX” thành “mọi bit ID/EX đều bất biến”.

## 6. Hai giao thức bộ nhớ khác nhau

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

Ví dụ lấy một lệnh tại A, có một cạnh chờ grant:

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

Ví dụ giao dịch dữ liệu có hai cạnh chờ, với `P={we,addr,wdata,wstrb}`:

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

## 7. Mở dạng sóng và tìm đúng tệp

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

| Dấu hiệu cần xem | Bổ sung tín hiệu | Tệp RTL / kiểm thử liên quan |
|---|---|---|
| Sai toán hạng, store ghi sai dữ liệu | `forward_rs*_sel`, `ex_rs*_value`, `idex_rs*_data_q`, `memwb_wb_data_q` | [hazard](../rtl/core/control/rv32_hazard_unit.v), [core](../rtl/core/rv32_core.v); [tb_rv32_core](../tb/core/tb_rv32_core.v) |
| Lệnh hoàn tất lặp khi bus chờ | `dmem_req_o`, `dmem_ready_i`, `memwb_valid_q`, `retire_valid_o` | [core](../rtl/core/rv32_core.v), [WB](../rtl/core/wb/rv32_wb_stage.v); [tb_rv32_core](../tb/core/tb_rv32_core.v) |
| Mất lệnh hoặc tràn chỗ IF | `request_accept`, `response_pop`, `fifo_pop`, ba bộ đếm/chỉ báo chỗ | [IF](../rtl/core/if/rv32_if_stage.v); [tb_rv32_if_stage](../tb/core/if/tb_rv32_if_stage.v), [tb_rv32_core_fetch](../tb/core/tb_rv32_core_fetch.v) |
| Lỗi sai đường trở thành trap | `ex_redirect_event`, `req_kill*_q`, `response_live`, `ifid_exc_valid_q` | [IF](../rtl/core/if/rv32_if_stage.v), [điều khiển](../rtl/core/control/rv32_pipeline_control.v); [tb_rv32_core_ordering](../tb/core/tb_rv32_core_ordering.v) |
| Sai cause hoặc sai lệnh bị trap | `*_exc_valid_q`, `*_exc_cause_q`, `mem_fault_event`, `wb_trap_event`, `trap_pc_o` | [ID](../rtl/core/id/rv32_id_stage.v), [EX](../rtl/core/ex/rv32_ex_stage.v), [MEM](../rtl/core/mem/rv32_mem_stage.v); [tb_rv32_core_traps](../tb/core/tb_rv32_core_traps.v), [tb_rv32_core_ordering](../tb/core/tb_rv32_core_ordering.v) |

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
