ducpl2006/riscv_soc_de10_lite/tmp/pdfs/images/paper_obj_50.jpg

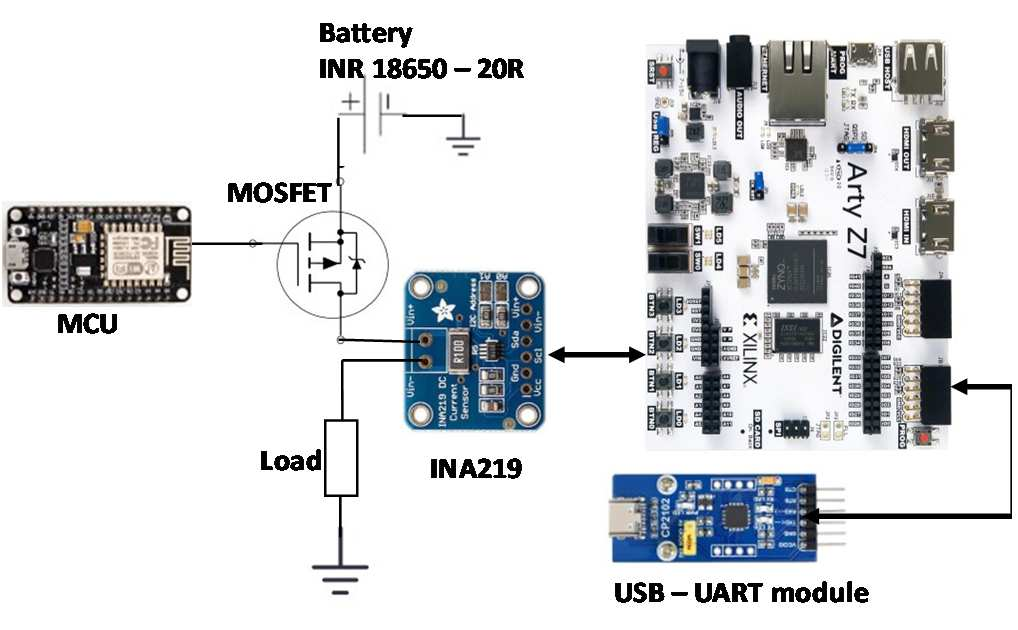
tmp/pdfs/images/paper_obj_50.jpg
