ducpl2006/riscv_soc_de10_lite/tmp/review_copy2_20260930/riscv_soc_de10_lite - Copy/rtl/core/control/rv32_pipeline_control.v

`default_nettype none

// Điều khiển pipeline tổ hợp; lỗi/redirect của lệnh già hơn chặn sự kiện trẻ hơn.
// MEM chờ thì giữ EX/MEM và ID/EX; WB cũ vẫn được commit đúng một lần.
// ifid_consumed xác nhận lấy đầu FIFO tại cạnh lên; không phải tín hiệu ready
// của memory. Core áp dụng reset và trap WB với ưu tiên cao nhất.
// Chi tiết ưu tiên và điều kiện chuyển: docs/giao_tiep_rtl_vi.md, mục 5.
module rv32_pipeline_control (
    // Nguồn thực sự được lệnh ID sử dụng để kiểm tra phụ thuộc load-use.
    input  wire [4:0]   id_rs1_addr_i,
    input  wire [4:0]   id_rs2_addr_i,
    input  wire         id_uses_rs1_i,
    input  wire         id_uses_rs2_i,

    // Lệnh đang ở EX: trạng thái ngoại lệ, đích load và hai nguồn thực thi.
    input  wire         valid_ex_i,
    input  wire         exc_valid_ex_i,
    input  wire         load_ex_i,
    input  wire [4:0]   rd_addr_ex_i,
    input  wire [4:0]   rs1_addr_ex_i,
    input  wire [4:0]   rs2_addr_ex_i,

    // Lệnh đang ở MEM: nguồn forwarding sớm, loại load và lệnh có ngoại lệ.
    input  wire         valid_mem_i,
    input  wire         exc_valid_mem_i,
    input  wire         reg_write_mem_i,
    input  wire         load_mem_i,
    input  wire [4:0]   rd_addr_mem_i,

    // Lệnh đang ở WB: nguồn forwarding sau khi kết quả đã sẵn sàng.
    input  wire         valid_wb_i,
    input  wire         exc_valid_wb_i,
    input  wire         reg_write_wb_i,
    input  wire [4:0]   rd_addr_wb_i,

    // Sự kiện MEM: lỗi chỉ xuất hiện tại req && ready; chờ MEM giữ các tầng trước.
    input  wire         mem_fault_raw_i,
    input  wire         mem_stall_i,

    // Sự kiện EX: lỗi căn chỉnh đã xét valid/ngoại lệ; nhánh còn cần phân xử
    // với MEM. Đích nhánh lệch hàng tạo lỗi, không tạo redirect.
    input  wire         ex_fault_raw_i,
    input  wire         ex_control_taken_i,
    input  wire         ex_target_misaligned_i,

    // Lệnh ID và lỗi giải mã mới; lỗi fetch đi kèm được chuyển tiếp riêng.
    input  wire         valid_id_i,
    input  wire         exc_valid_id_i,
    input  wire         id_decode_exc_i,

    // Dừng core hoặc chốt trap WB: ngăn ID lấy thêm lệnh từ FIFO.
    input  wire         halted_i,
    input  wire         wb_trap_event_i,

    // Chọn hai nguồn EX: 00=ID/EX, 01=MEM/WB, 10=EX/MEM; MEM ưu tiên WB.
    output wire [1:0]   forward_rs1_sel_o,
    output wire [1:0]   forward_rs2_sel_o,

    // Sự kiện sau phân xử: MEM chặn EX; lỗi/redirect EX chặn ngoại lệ ID
    // và stall load-use. Reset/trap WB được ưu tiên tại core.
    output wire         mem_fault_event_o,
    output wire         ex_fault_event_o,
    output wire         ex_redirect_event_o,
    output wire         id_exception_event_o,
    output wire         load_use_stall_o,

    // Lấy đầu FIFO IF/ID tại cạnh lên khi ID được tiến; không phải ready bus.
    output wire         consumed_id_o
);

    // Hazard load-use trước khi phân xử với stall MEM và flush do lỗi/redirect.
    wire load_use_stall_raw;

    // Loại lệnh có ngoại lệ khỏi mọi nguồn hazard/forwarding.
    rv32_hazard_unit u_hazard_unit (
        .id_rs1_addr_i    (id_rs1_addr_i),
        .id_rs2_addr_i    (id_rs2_addr_i),
        .id_uses_rs1_i    (id_uses_rs1_i),
        .id_uses_rs2_i    (id_uses_rs2_i),
        .ex_valid_i       (valid_ex_i && !exc_valid_ex_i),
        .ex_load_i        (load_ex_i),
        .ex_rd_addr_i     (rd_addr_ex_i),
        .ex_rs1_addr_i    (rs1_addr_ex_i),
        .ex_rs2_addr_i    (rs2_addr_ex_i),
        .mem_valid_i      (valid_mem_i && !exc_valid_mem_i),
        .mem_reg_write_i  (reg_write_mem_i),
        .mem_load_i       (load_mem_i),
        .mem_rd_addr_i    (rd_addr_mem_i),
        .wb_valid_i       (valid_wb_i && !exc_valid_wb_i),
        .wb_reg_write_i   (reg_write_wb_i),
        .wb_rd_addr_i     (rd_addr_wb_i),
        .stall_load_use_o (load_use_stall_raw),
        .forward_rs1_o    (forward_rs1_sel_o),
        .forward_rs2_o    (forward_rs2_sel_o)
    );

    // MEM chứa lệnh già hơn EX: lỗi MEM thắng lỗi/redirect EX.
    // Khi MEM chờ, EX chưa được phát lỗi hoặc đổi luồng điều khiển.
    assign mem_fault_event_o = mem_fault_raw_i;
    assign ex_fault_event_o = ex_fault_raw_i && !mem_stall_i &&
                              !mem_fault_event_o;
    assign ex_redirect_event_o = valid_ex_i && !exc_valid_ex_i &&
                                 ex_control_taken_i && !ex_target_misaligned_i &&
                                 !mem_stall_i && !mem_fault_event_o;

    // Chỉ xét ID sau khi đã loại mọi sự kiện ưu tiên ở MEM/EX.
    assign id_exception_event_o = valid_id_i && !exc_valid_id_i &&
                                  id_decode_exc_i && !mem_stall_i &&
                                  !mem_fault_event_o && !ex_fault_event_o &&
                                  !ex_redirect_event_o;
    assign load_use_stall_o = load_use_stall_raw && !mem_stall_i &&
                              !mem_fault_event_o && !ex_fault_event_o &&
                              !ex_redirect_event_o;

    // Cho phép ID tiến khi không halt, trap, stall hoặc sự kiện MEM/EX ưu tiên.
    wire id_can_advance;

    assign id_can_advance = !halted_i && !wb_trap_event_i && !mem_stall_i &&
                            !mem_fault_event_o && !ex_fault_event_o &&
                            !ex_redirect_event_o && !load_use_stall_o;

    // Ngoại lệ mới tại ID vẫn tiêu thụ lệnh: metadata lỗi được chuyển sang EX.
    assign consumed_id_o = valid_id_i && id_can_advance;

endmodule

`default_nettype wire
