ducpl2006/riscv_soc_de10_lite/tmp/reference_soc_cnn/SoC_CNN_Driver/Testbench/tb_CPU.v

`timescale 1ns/1ps

// ============================================================
// Testbench: tb_CPU
// Firmware: firmware.hex (comprehensive CPU test)
//
// Architecture: CPU với external memory interface (SoC)
//   CPU ports: addrM, write_dataM, mem_writeM, mem_readM, read_dataM
//   Memory model: synchronous BRAM (khớp M9K latency + bram_stall)
//
// Expected final state:
//   x2 = 0x00000FE0  (SP = 0x1000 - 32)
//
//   tb_mem[64]  = 17          ADD   : 5 + 12
//   tb_mem[65]  = 7           SUB   : 12 - 5
//   tb_mem[66]  = 4           AND   : 5 & 12
//   tb_mem[67]  = 13          OR    : 5 | 12
//   tb_mem[68]  = 9           XOR   : 5 ^ 12
//   tb_mem[69]  = 20          SLL   : 5 << 2
//   tb_mem[70]  = 6           SRL   : 12 >> 1
//   tb_mem[71]  = 0xFFFFFFFC  SRA   : -8 >> 1
//   tb_mem[72]  = 1           SLT   : 5 < 12
//   tb_mem[73]  = 1           SLTU  : 5 < 12 unsigned
//   tb_mem[74]  = 0x12000000  LUI
//   tb_mem[75]  = 99          LW/SW + load-use hazard
//   tb_mem[76]  = 1           BEQ   taken
//   tb_mem[77]  = 1           BNE   taken
//   tb_mem[78]  = 1           BLT   taken
//   tb_mem[79]  = 1           BGE   taken
//   tb_mem[80]  = 1           BLTU  taken
//   tb_mem[81]  = 10          JAL + JALR : fn_add(3,7)
//   tb_mem[82]  = 39          Forwarding chain EX->EX
//   tb_mem[83]  = 5           Loop (backward branch x5)
// ============================================================

module tb_CPU;

    // ========================
    // SIGNALS
    // ========================
    reg  clk;
    reg  reset;

    // CPU Memory Interface
    wire [31:0] addrM;
    wire [31:0] write_dataM;
    wire        mem_writeM;
    wire        mem_readM;
    reg  [31:0] read_dataM;

    integer pass_count;
    integer fail_count;
    integer j;

    // ========================
    // CLOCK 50MHz (20ns)
    // ========================
    initial clk = 0;
    always #10 clk = ~clk;

    // ========================
    // RESET (active low)
    // ========================
    initial begin
        reset = 0;
        #50;
        reset = 1;
    end

    // ========================
    // DUT
    // ========================
    CPU dut (
        .clk        (clk),
        .reset      (reset),
        .read_dataM (read_dataM),
        .addrM      (addrM),
        .write_dataM(write_dataM),
        .mem_writeM (mem_writeM),
        .mem_readM  (mem_readM)
    );
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
